jk1mly/pcb-qrp-fm/README.md

# pcb-qrp-fm
おもちゃのトランシーバ用のICを使うための基板

モノバンドで使用したり、無線機部分だけにして外部にアンプやフィルタを作る想定の基板
参考用のROMファイルも登録してあるが、最新状態はソフトのレポジトリを参照
