jk1mly/pcb-qrp-fm/fm_qrp3_sch.pdf

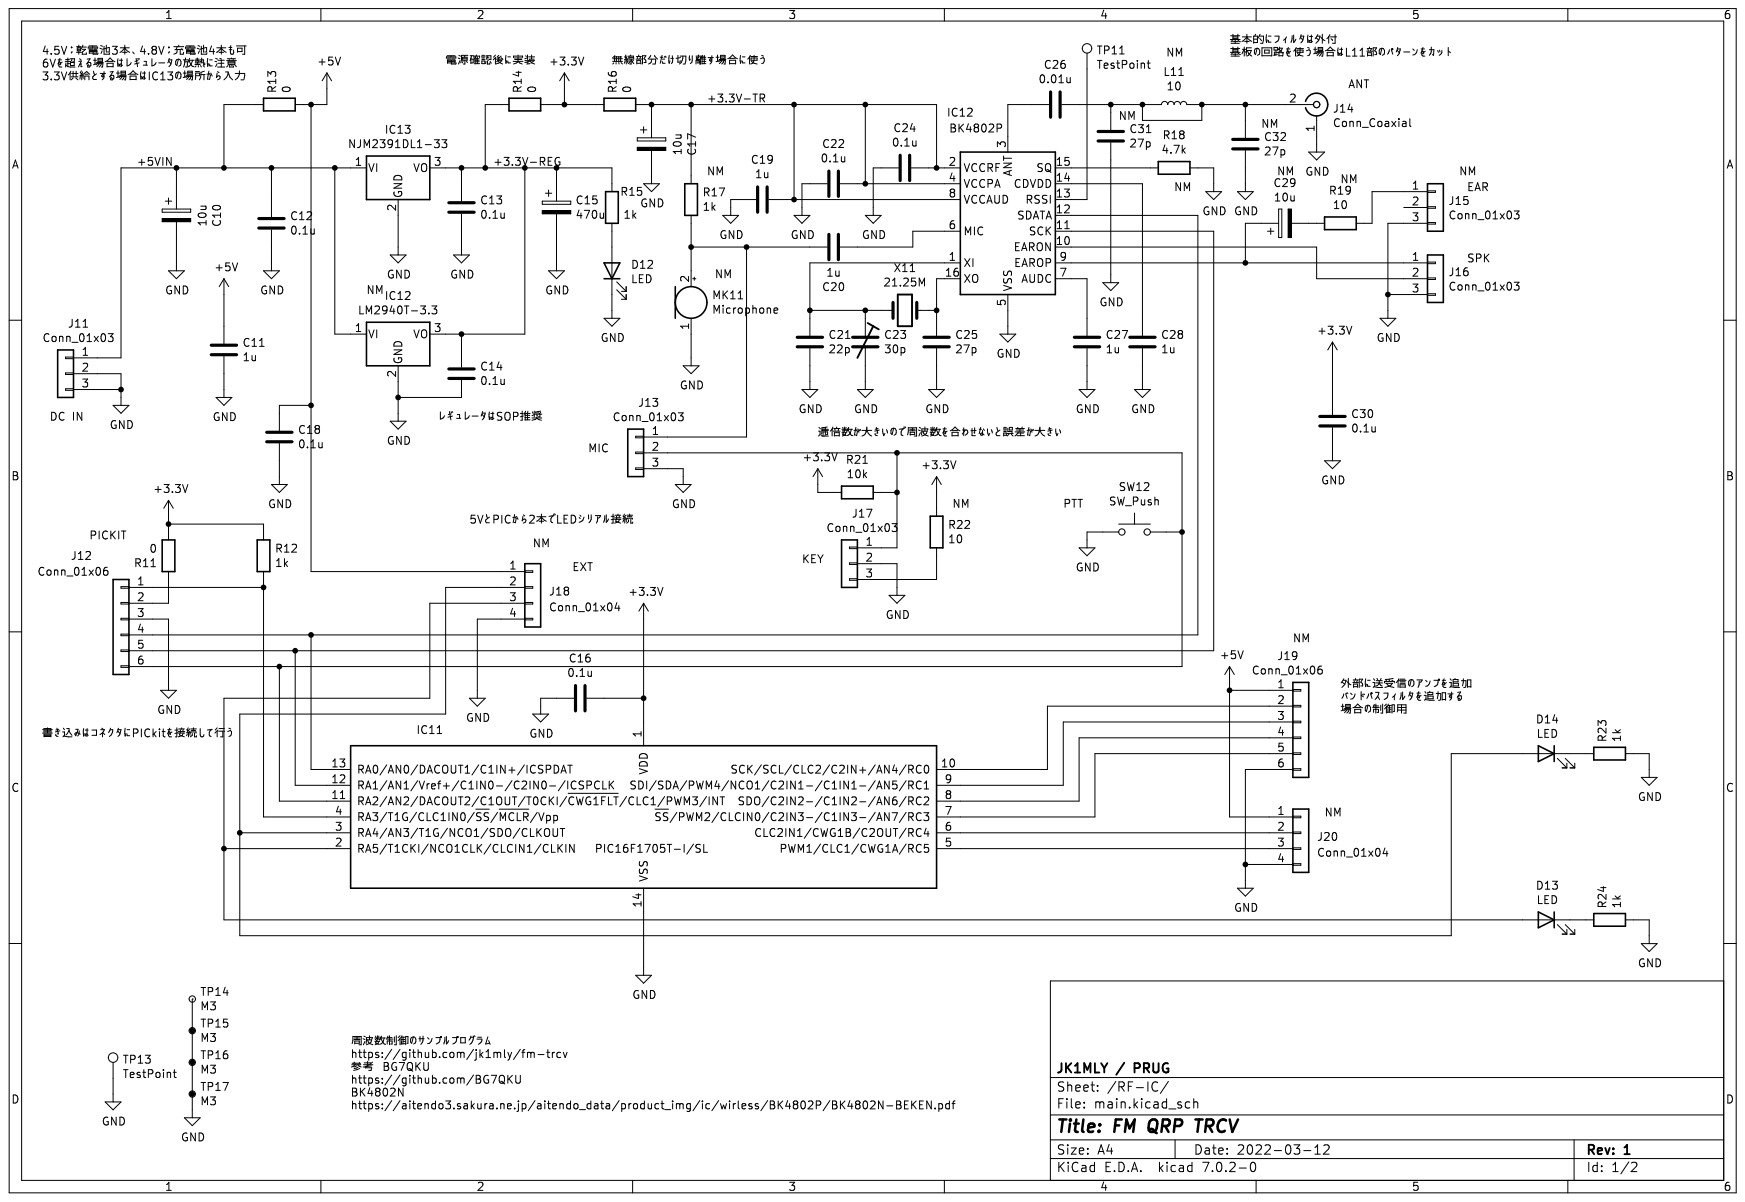
[picture p12: page 1]
