jk1mly/pcb-qrp-fm/fm_qrp3.kicad_pcb

## KiCad design fm_qrp3.kicad_pcb (2023-08-06)

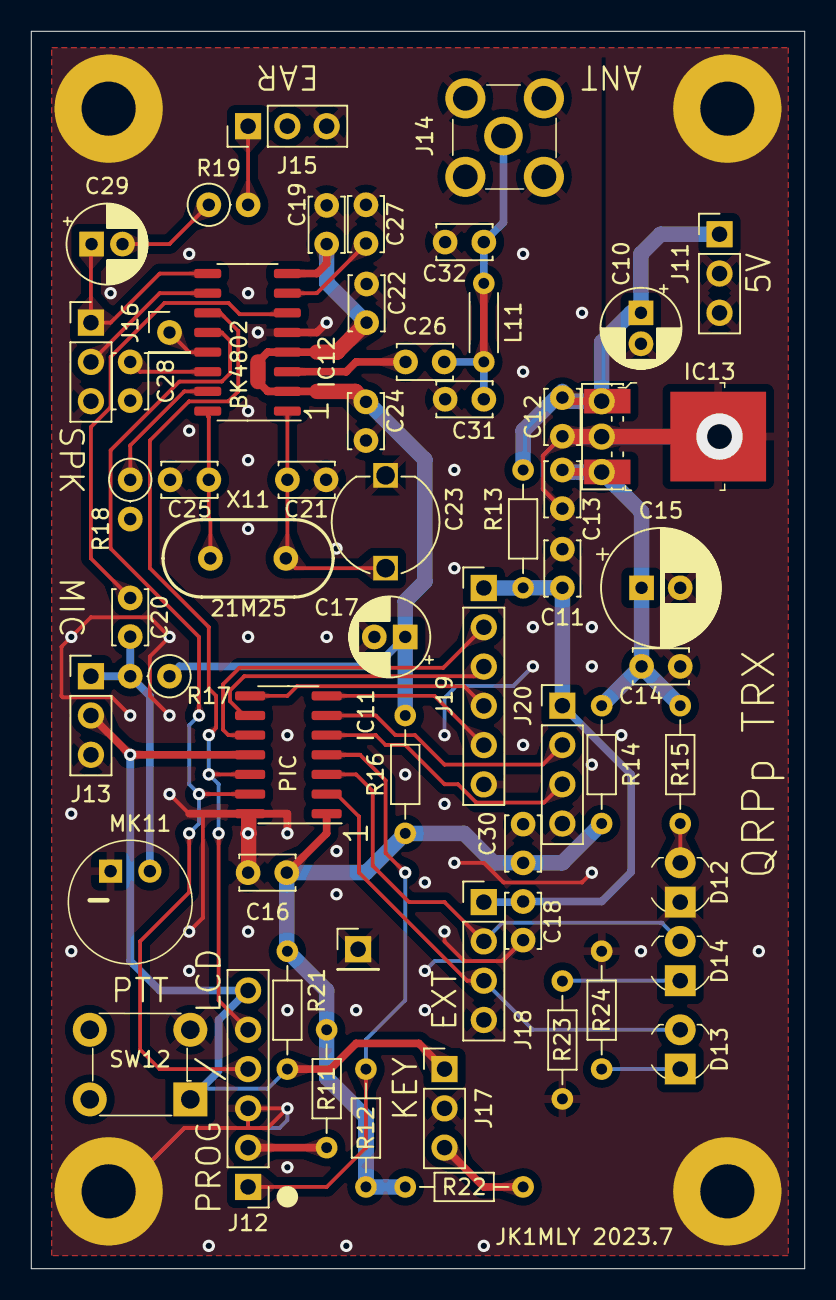
[picture p13: board fm_qrp3.kicad_pcb from above]

Board: 2 copper layers, 50.0 x 80.0 mm, 63 parts (0 on the bottom side), 37 nets.

Parts:
C10, C17, C29: 10u; CP_Radial_D5.0mm_P2.00mm
C11, C19, C22, C24, C27, C28: 1u; C_Disc_D3.4mm_W2.1mm_P2.50mm
C12, C13, C14, C16, C18, C20, C30: 0.1u; C_Disc_D3.4mm_W2.1mm_P2.50mm
C15: 470u; CP_Radial_D7.5mm_P2.50mm
C21: 22p; C_Disc_D3.4mm_W2.1mm_P2.50mm
C23: 10p; C_TRIM_P6.00mm
C25, C31, C32: 27p; C_Disc_D3.4mm_W2.1mm_P2.50mm
C26: 0.01u; C_Disc_D3.4mm_W2.1mm_P2.50mm
D12, D13, D14: LED; LED_3mm_Radial
IC11: PIC16F1503T-I/SL; SO-14_3.9x8.65mm_P1.27mm
IC12: BK4802P; SO-16_3.9x9.9mm_P1.27mm
IC13: LM2940T-3.3; TO-251-3_Vertical
J11, J13, J15, J16, J17: Conn_01x03; PinHeader_1x03_P2.54mm_Vertical
J12, J19: Conn_01x06; PinHeader_1x06_P2.54mm_Vertical
J14: Conn_Coaxial; RF_SMA_Vertical_5-1814832-1
J18, J20: Conn_01x04; PinHeader_1x04_P2.54mm_Vertical
L11: 10; R_Axial_DIN0204_L3.6mm_D1.6mm_P5.08mm_Horizontal
MK11: Microphone; Mic_CMA-4544PF-W
R11, R13, R14, R16: 0; R_Axial_DIN0204_L3.6mm_D1.6mm_P7.62mm_Horizontal
R12, R15, R23, R24: 1k; R_Axial_DIN0204_L3.6mm_D1.6mm_P7.62mm_Horizontal
R17: 1k; R_Axial_DIN0207_L6.3mm_D2.5mm_P2.54mm_Vertical
R18: 4.7k; R_Axial_DIN0207_L6.3mm_D2.5mm_P2.54mm_Vertical
R19: 10; R_Axial_DIN0207_L6.3mm_D2.5mm_P2.54mm_Vertical
R21: 10k; R_Axial_DIN0204_L3.6mm_D1.6mm_P7.62mm_Horizontal
R22: 10; R_Axial_DIN0204_L3.6mm_D1.6mm_P7.62mm_Horizontal
SW12: SW_Push; Switch_Tactile_THT_6x6mm
TP11, TP13: TestPoint; PinHeader_1x01_P2.54mm_Vertical
TP14, TP15, TP16, TP17: M3; MountingHole_3.5mm_Pad
U12: NJM2391DL1-33; TO-252-3
X11: 21.25M; HC49

Connections:
+3V3: C16.2, C30.1, IC11.1 (VDD), R11.2, R12.1, R14.2, R16.1, R21.1, R22.1
+5V: C11.1, C18.1, J18.1, J19.1, J20.1, R13.2
/RF-IC/+3.3V-REG: C13.1, C14.1, C15.1, IC13.3 (VO), R14.1, R15.1, U12.3 (VO)
/RF-IC/+3.3V-TR: C17.1, C19.2, C22.2, C24.2, IC12.2 (VCCRF), IC12.4 (VCCPA), IC12.8 (VCCAUD), R16.2, R17.1
/RF-IC/+5VIN: C10.1, C12.1, IC13.1 (VI), J11.1, R13.1, U12.1 (VI)
GND: C10.2, C11.2, C12.2, C13.2, C14.2, C15.2, C16.1, C17.2, C18.2, C19.1, C21.2, C22.1, C23.2, C24.1, C25.2, C27.2, C28.2, C30.2, C31.2, C32.2, D12.1 (K), IC11.14 (VSS), IC12.5 (VSS), IC13.2 (GND), J11.2, J11.3, J12.3, J13.3, J14.1 (G), J15.3, J16.3, J17.2, J18.4, J19.6, J20.4, MK11.1 (-), R18.2, R23.2, R24.2, SW12.2, TP13.1, TP14.1, TP15.1, TP16.1, TP17.1, U12.2 (GND)
unnamed: C29.2, R19.1
unnamed: D12.2 (A), R15.2
unnamed: D13.2 (A), IC11.2 (RA5/T1CKI/NCO1CLK/CLCIN1/CLKIN), J18.3
unnamed: D13.1 (K), R24.1
unnamed: D14.2 (A), IC11.3 (RA4/AN3/T1G/NCO1/SDO/CLKOUT), J18.2
unnamed: D14.1 (K), R23.1
unnamed: IC11.6 (CLC2IN1/CWG1B/C2OUT/RC4), J20.2
unnamed: IC11.5 (PWM1/CLC1/CWG1A/RC5), J20.3
unnamed: IC11.13 (RA0/AN0/DACOUT1/C1IN+/ICSPDAT), IC12.12 (SDATA), J12.4
unnamed: IC11.12 (RA1/AN1/Vref+/C1IN0-/C2IN0-/ICSPCLK), IC12.11 (SCK), J12.5
unnamed: IC11.11 (RA2/AN2/DACOUT2/C1OUT/T0CKI/~CWG1FLT/CL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), J12.6, J13.2, J17.1, R21.2, SW12.1
unnamed: IC11.4 (RA3/T1G/CLC1IN0/~SS/~MCLR/Vpp), J12.1, R12.2
unnamed: IC11.10 (SCK/SCL/CLC2/C2IN+/AN4/RC0), J19.2
unnamed: IC11.9 (SDI/SDA/PWM4/NCO1/C2IN1-/C1IN1-/AN5/RC1), J19.3
unnamed: IC11.8 (SDO/C2IN2-/C1IN2-/AN6/RC2), J19.4
unnamed: IC11.7 (~SS/PWM2/CLCIN0/C2IN3-/C1IN3-/AN7/RC3), J19.5
unnamed: C26.1, IC12.3 (ANT)
unnamed: C27.1, IC12.7 (AUDC)
unnamed: C28.1, IC12.14 (CDVDD)
unnamed: IC12.10 (EARON), J16.2
unnamed: C29.1, IC12.9 (EAROP), J16.1
unnamed: C20.2, IC12.6 (MIC)
unnamed: IC12.13 (RSSI), TP11.1
unnamed: IC12.15 (SQ), R18.1
unnamed: C21.1, C23.1, IC12.1 (XI), X11.1
unnamed: C25.1, IC12.16 (XO), X11.2
unnamed: J12.2, R11.1
unnamed: C20.1, J13.1, MK11.2 (+), R17.2
unnamed: C26.2, C31.1, C32.1, J14.2 (S), L11.1, L11.2
unnamed: J15.1, R19.2
unnamed: J17.3, R22.2
