jk1mly/pcb-qrp-fm/(commit log)

2022-03-08 jumper
    タクトスイッチの配線ミス
    スイッチのリードをカットして実装 IMG_5911.jpegでcutの位置
    ジャンパ配線 IMG_5911.jpegの2本
2022-03-12 部品定数を入力 ただし未評価
    [bpf-tun.kicad_sch, bpf144.kicad_sch, bpf28.kicad_sch, bpf430.kicad_sch, bpf50.kicad_sch, fm-qrp.kicad_sch, main.kicad_sch]
2022-03-12 部品実装用
2022-03-12 シルク表示修正
    [fm-qrp.kicad_pcb]
2022-03-21 バンドパスフィルタの定数を見直し（単体試験の反映）
    [bpf144.kicad_sch, bpf430.kicad_sch, bpf50.kicad_sch, fm-qrp.kicad_sch, main.kicad_sch]
2023-06-25 Add files via upload
    フィルタ回路変更とジャンパクリーン
    [bpf144.kicad_sch, bpf28.kicad_sch, bpf430.kicad_sch, bpf50.kicad_sch, fm_qrp2.kicad_pcb, fm_qrp2.kicad_sch, main.kicad_sch]
2023-08-06 モノバンド版
    [fm_qrp3.kicad_pcb, fm_qrp3.kicad_sch, main.kicad_sch]
